CuriousTech/WiFi_Waterbed_Heater-2/README.md

# WiFi Waterbed Heater 2  
  
Discontinued, go here: [WiFiWaterbedHeater3](https://github.com/CuriousTech/WiFiWaterbedHeater3)
