CuriousTech/WiFi_Waterbed_Heater-2/3D/WBbtn.stl

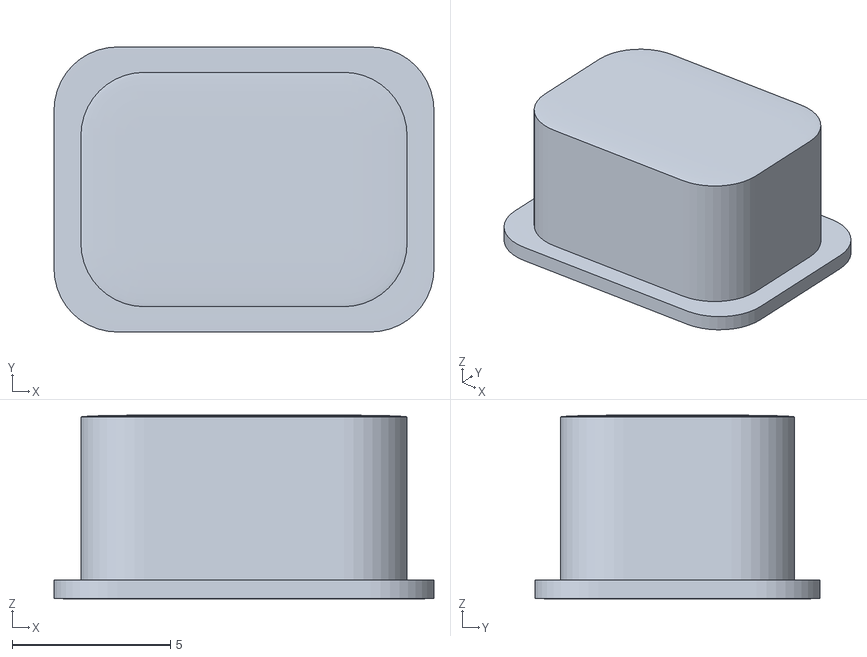
[picture p1: CAD file, 2020-01-23]
3D/WBbtn.stl
12.0 x 9.00 x 5.80
