CuriousTech/WiFi_Waterbed_Heater-2/3D/WBback.stl

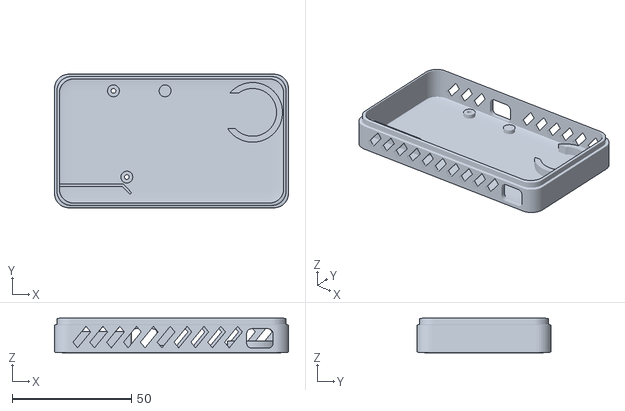
[picture p2: CAD file, 2020-01-23]
3D/WBback.stl
98.0 x 56.0 x 14.5
