CuriousTech/WiFi_Waterbed_Heater-2/Eagle/Supply/WaterbedSlave.brd

## EAGLE design Eagle/Supply/WaterbedSlave.brd (2020-01-21)

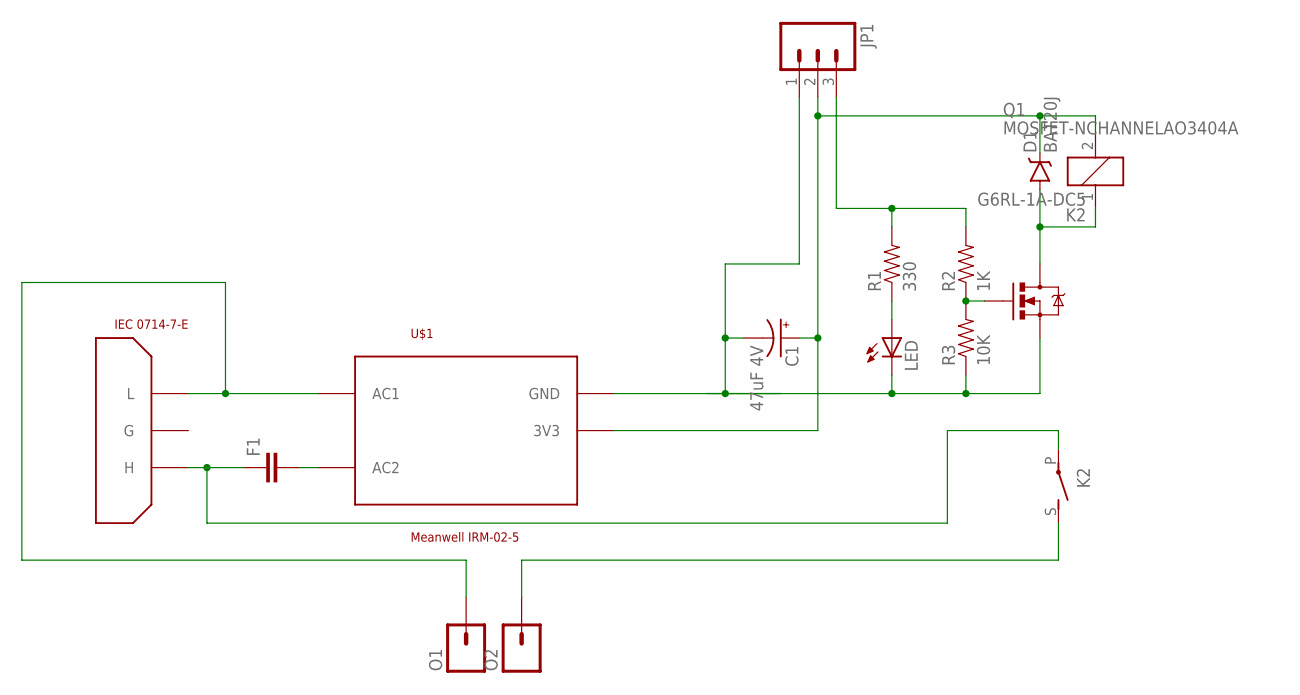
[picture p3: schematic WaterbedSlave.sch]

Parts:
C1: 47uF 4V; CPOL-RADIAL-10UF-25V
D1: BAT20J; SOD-323
F1: CAPPTH1; CAP-PTH-5MM
JP1: M03POLAR_LOCK; MOLEX-1X3_LOCK
K2: G6RL-1A-DC5; G6RS
LED: LEDCHIPLED_0805; CHIPLED_0805
O1, O2: M01PTH_2MM; 1X01_2MM
Q1: MOSFET-NCHANNELAO3404A; SOT23-3
R1: 330; 0805
R2: 1K; 0805
R3: 10K; 0805
U$1: Meanwell IRM-02-5; RAC02-3.3SC
U$3: IEC 0714-7-E; IEC

Connections:
3V3: C1.1 (+), D1.C, JP1.2, K2.2, U$1.GND (3V3)
GND: C1.2 (-), JP1.1, LED.C, Q1.2 (S), R3.1, U$1.3V3 (GND)
unnamed: O1.1, U$1.AC1, U$3.L
unnamed: F1.2, U$1.AC2
unnamed: K2.S, O2.1
unnamed: F1.1, K2.P, U$3.H
unnamed: D1.A, K2.1, Q1.3 (D)
unnamed: LED.A, R1.1
unnamed: JP1.3, R1.2, R2.2
unnamed: Q1.1 (G), R2.1, R3.2

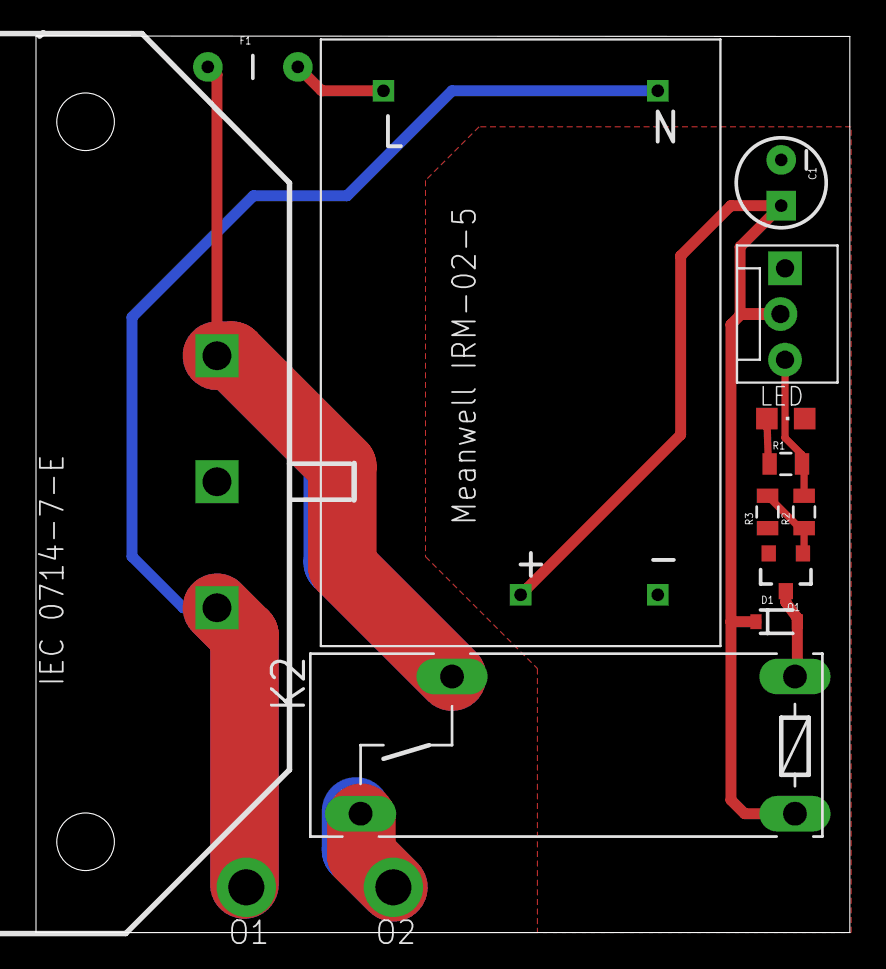
[picture p4: board WaterbedSlave.brd from above]

Board: 2 copper layers, 45.2 x 49.8 mm, 14 parts (0 on the bottom side), 10 nets.
