CuriousTech/WiFi_Waterbed_Heater-2/Eagle/WBH2.brd

## EAGLE design Eagle/WBH2.brd (2020-01-20)

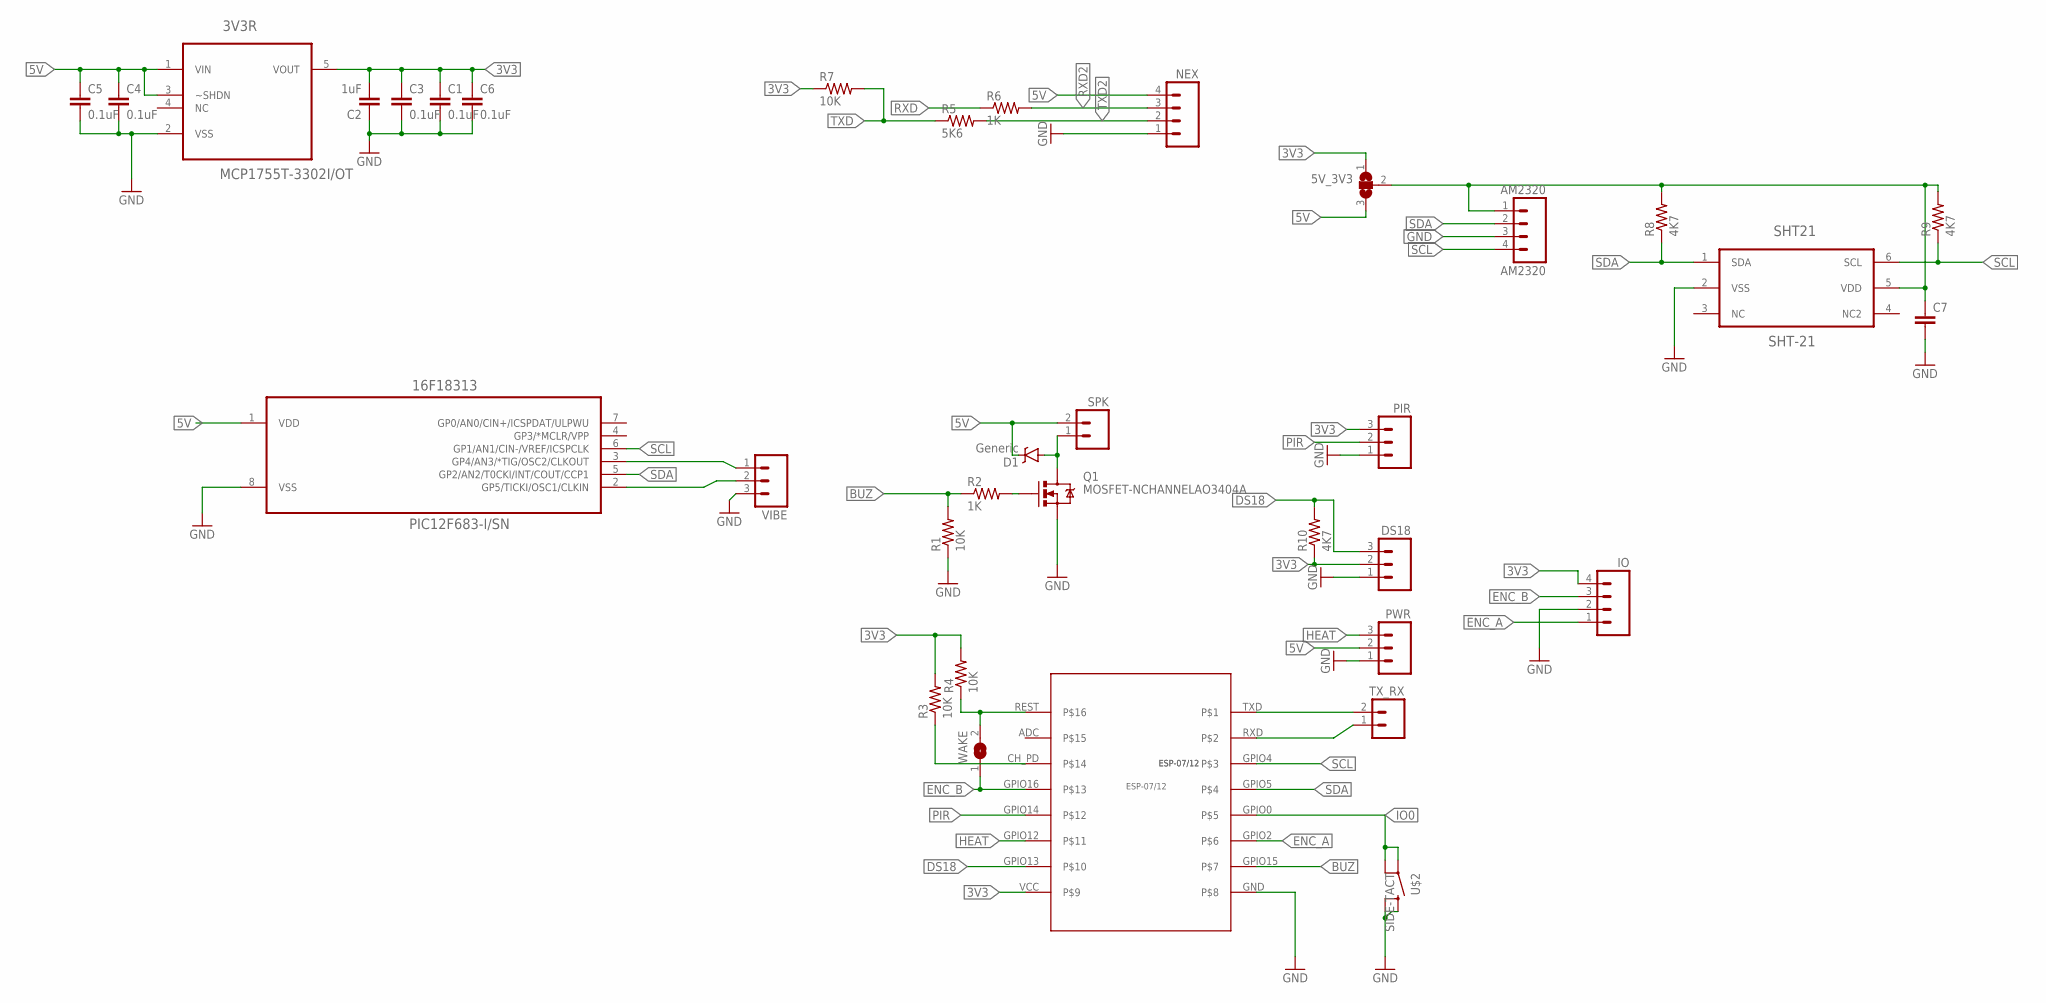
[picture p5: schematic WBH2.sch]

Parts:
3V3R: MCP1755T-3302I/OT; SOT95P270X145-5N
5V_3V3: SJ2W; SJ_2
16F18313: PIC12F683-I/SN; SOIC127P600X175-8N
AM2320: AM2320; 1X04
C1, C3, C4, C5, C6: 0.1uF; 0805
C2: 1uF; 0805
C7: CAP0603-CAP; 0603-CAP
D1: Generic; SOD-323
DS18: M03PTH; 1X03
IO: M04PTH; 1X04
NEX: M04PTH; 1X04
PIR: M03PTH; 1X03
PWR: M03PTH; 1X03
Q1: MOSFET-NCHANNELAO3404A; SOT23-3
R1, R3, R4, R7: 10K; 0805
R2, R6: 1K; 0805
R5: 5K6; 0805
R8, R9, R10: 4K7; 0805
SHT21: SHT-21; SHT21
SPK: M02PTH; 1X02
TX_RX: M02PTH; 1X02
U$1: ESP-07/12
U$2: SIDE-TACT
VIBE: M03PTH; 1X03
WAKE: SJ

Connections:
3V3: 3V3R.5 (VOUT), 5V_3V3.1, C1.1, C2.2, C3.1, C6.1, DS18.2, IO.4, PIR.3, R3.2, R4.2, R7.1, R10.1, U$1.VCC
5V: 3V3R.1 (VIN), 3V3R.3 (~SHDN), 5V_3V3.3, 16F18313.1 (VDD), C4.1, C5.1, D1.C, NEX.4, PWR.2, SPK.2
BUZ: R1.2, R2.1, U$1.GPIO15
DS18: DS18.3, R10.2, U$1.GPIO13
ENC_A: IO.1, U$1.GPIO2
ENC_B: IO.3, U$1.GPIO16, WAKE.1
GND: 3V3R.2 (VSS), 16F18313.8 (VSS), AM2320.3, C1.2, C2.1, C3.2, C4.2, C5.2, C6.2, C7.2, DS18.1, IO.2, NEX.1, PIR.1, PWR.1, Q1.2 (S), R1.1, SHT21.2 (VSS), U$1.GND, U$2.3 (2), U$2.4, VIBE.3
HEAT: PWR.3, U$1.GPIO12
IO0: U$1.GPIO0, U$2.1, U$2.2 (3)
unnamed: 16F18313.3 (GP4/AN3/*TIG/OSC2/CLKOUT), VIBE.1
unnamed: 16F18313.2 (GP5/TICKI/OSC1/CLKIN), VIBE.2
unnamed: D1.A, Q1.3 (D), SPK.1
unnamed: Q1.1 (G), R2.2
unnamed: R3.1, U$1.CH_PD
NC: SHT21.3 (NC)
PIR: PIR.2, U$1.GPIO14
PWR: 5V_3V3.2, AM2320.1, C7.1, R8.2, R9.2, SHT21.5 (VDD)
REST: R4.1, U$1.REST, WAKE.2
RXD: R6.1, TX_RX.1, U$1.RXD
RXD2: NEX.3, R6.2
SCL: 16F18313.6 (GP1/AN1/CIN-/VREF/ICSPCLK), AM2320.4, R9.1, SHT21.6 (SCL), U$1.GPIO4
SDA: 16F18313.5 (GP2/AN2/T0CKI/INT/COUT/CCP1), AM2320.2, R8.1, SHT21.1 (SDA), U$1.GPIO5
TXD: R5.1, R7.2, TX_RX.2, U$1.TXD
TXD2: NEX.2, R5.2

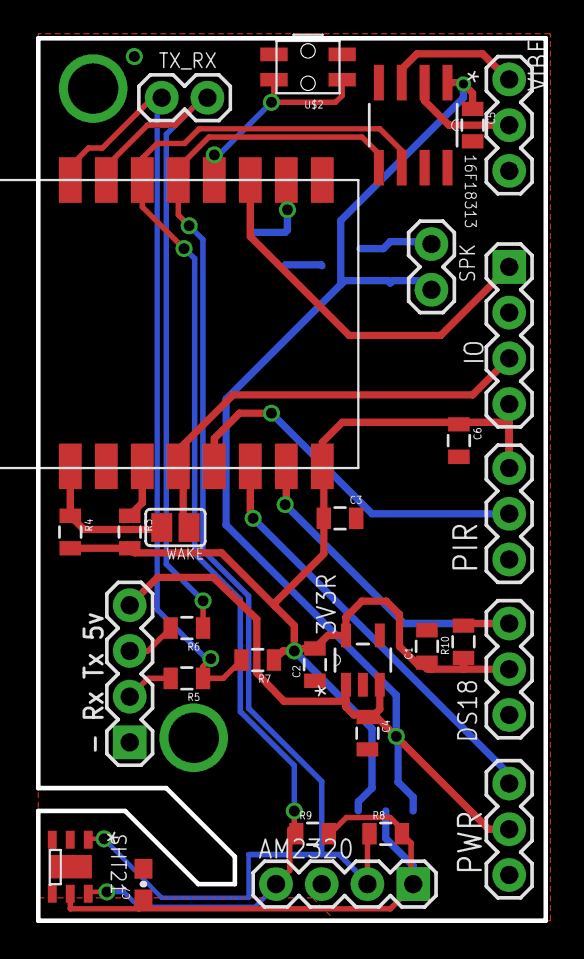
[picture p6: board WBH2.brd from above]

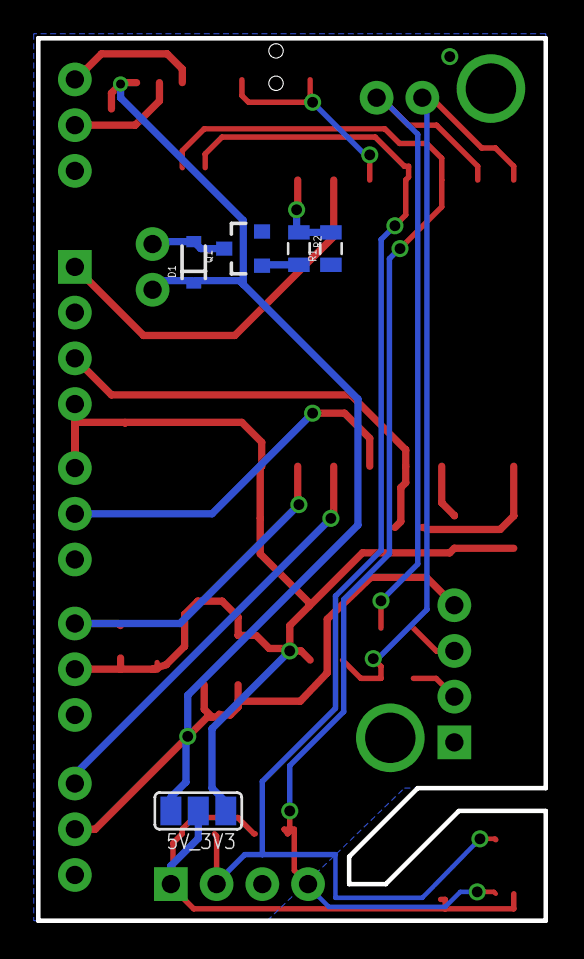
[picture p7: board WBH2.brd from below]

Board: 2 copper layers, 28.2 x 49.0 mm, 35 parts (5 on the bottom side), 23 nets.
