CuriousTech/WiFi_Waterbed_Heater-2/Arduino/display.cpp

#include "display.h"
#include "Nextion.h"
#include <ESPAsyncWebServer.h> // https://github.com/me-no-dev/ESPAsyncWebServer
#include <TimeLib.h>
#ifdef ESP32
#include <ESPmDNS.h>
#else
#include <ESP8266mDNS.h> // for WiFi.RSSI()
#endif
#include "eeMem.h"
#include "tempArray.h"
#include "music.h"

Nextion nex;
extern Music mus;
extern void changeTemp(int delta, bool bAll);
extern void CallHost(reportReason r);
extern bool bNotifAck;

extern TempArray ta;

void Display::init()
{
  nex.FFF(); // Just to end any debug strings in the Nextion
  nex.reset();
  screen( true ); // brighten the screen if it just reset
  nex.autoWake(true);
  refreshAll();
}

// called each second
void Display::oneSec()
{
  if(nex.getPage() == Page_Main)
  {
    refreshAll();    // time update every seconds
    updateRSSI();     //
    if( m_backlightTimer ) // the dimmer thing
    {
      if(--m_backlightTimer == 0)
        screen(false);
    }
  }
  else if(nex.getPage() == Page_Clock)
  {
    refreshClock();
  }
}

bool Display::checkNextion() // all the Nextion recieved commands
{
  static char cBuf[66];
  int len = nex.service(cBuf); // returns just the button value or 0 if no data
  uint8_t btn;
  uint32_t val;
  String s;
  static uint8_t textIdx = 0;
  bool bRtn = false;

  if(len == 0)
  {
    if(m_btnMode)
      if(--m_btnDelay <= 0)
      {
        buttonRepeat();
        m_btnDelay = 40; // repeat speed
      }
    return false;
  }

  switch(cBuf[0])  // code
  {
    case 0x65: // button
      bRtn = true; // anything pressed
      btn = cBuf[2];
      if( m_backlightTimer == 0)
      {
        nex.brightness(NEX_BRIGHT); // backlight was off, ignore this input
        m_backlightTimer = NEX_TIMEOUT;
        return bRtn;
      }
      if(cBuf[3]) // press, not release
        mus.add(6000, 20);

      switch(cBuf[1]) // page
      {
        case Page_Main:
          m_backlightTimer = NEX_TIMEOUT;
          switch(btn)
          {
            case 0: // screen (not used)
              break;
            case 1: // TIME
              break;
            case 4: // alarm
              m_bAlarmOn = !m_bAlarmOn;
              refreshAll();
              break;
            case 6: // temp up
              if(ee.bVaca) // first tap, disable vacation mode
                ee.bVaca = false;
              else
              {
                if(cBuf[3])
                {
                  m_btnMode = 1;
                  buttonRepeat();
                  m_btnDelay = 120;
                }
                else m_btnMode = 0;
              }
              break;
            case 7: // temp down
              if(ee.bVaca) // disable vacation mode
                ee.bVaca = false;
              else
              {
                if(cBuf[3])
                {
                  m_btnMode = 2;
                  buttonRepeat();
                  m_btnDelay = 120;
                }
                else m_btnMode = 0;
              }
              break;
            case 5: // dimmer slider
              if(cBuf[3]) // press
              {
                nex.getVal(0);
                m_bSliderDn = true;
              }
              else m_bSliderDn = false;
              break;
            case 14: // Light
              m_bLightOn = !m_bLightOn;
              m_LightSet = 1;
              break;
            case 17: // Alarm page
              nex.setPage(Page_Alarms); // set alarms
              updateAlarms();
              break;
            case 18: // Schedule page
              nex.setPage(Page_Schedule);
              updateSchedule();
              break;
            case 19: // Thermostat page
              break;
            case 26: // notifications ack
              m_bNotifVis = false;
              for(int i = 0; i < NOTIFS; i++)
              {
                if(m_Notif[i].s.length())
                {
                  nex.itemText(18, m_Notif[i].s);
                  m_sNotifCurr = m_Notif[i].s;
                  m_Notif[i].s = "";
                  m_bNotifVis = true;
                  break;
                }
              }
              if(m_bNotifVis == false)
                nex.visible("t18", 0);
//              if(m_notifIP[0])
  //            {
                bNotifAck = true;
                CallHost(Reason_Notif);
    //            m_notifIP[0] = 0;
      //        }
              break;
          }
          break;
        case Page_Thermostat:
          break;
        case Page_SSID: // Selection page t1=ID 2 ~ t16=ID 17
          WiFi.SSID(cBuf[2]-2).toCharArray(ee.szSSID, sizeof(ee.szSSID) );
          nex.refreshItem("t0"); // Just to terminate any debug strings in the Nextion
          nex.setPage(Page_Keyboard); // go to keyboard
          nex.itemText(1, "Enter Password");
          textIdx = 2; // AP password
          break;

        case Page_Alarms:
          switch(btn)
          {
            case 1: // up
              if(cBuf[3])
              {
                m_btnMode = 1;
                buttonRepeat();
                m_btnDelay = 120;
              }
              else m_btnMode = 0;
              break;
            case 2: // down
              if(cBuf[3])
              {
                m_btnMode = 2;
                buttonRepeat();
                m_btnDelay = 120;
              }
              else m_btnMode = 0;
              break;
            case 3 ... 17: // hour, minute, Am/Pm
              s = String("t") + m_almSelect; // change color back
              nex.itemColor(s, rgb16(0, 63, 31));
              m_almSelect = btn - 3;
              s = String("t") + m_almSelect; // change to new selection
              nex.itemColor(s, rgb16(31, 63, 31));
              updateAlarms();
              break;
            case 19 ... 53: // checkboxes
              {
                uint8_t alm = (btn-19)/7;
                uint8_t bit = (btn-19)%7;
                ee.alarm[alm].wday ^= 1 << bit;
              }
              break;
            case 18: // Main
              nex.setPage(Page_Main);
              delay(25);
              refreshAll();
              break;
          }
          break;
        case Page_Schedule:
          switch(btn)
          {
            case 1:
              nex.setPage(Page_Main);
              delay(25);
              refreshAll();
              break;
            case 3: // up
              schedUpDown(true);
              break;
            case 4: // down
              schedUpDown(false);
              break;
            case 5: case 6: case 7: case 8: case 9:
              selectSched(btn-5, 0); // name
              break;
            case 10: case 11: case 12: case 13: case 14:
              selectSched(btn-10, 1); // hour
              break;
            case 15: case 16: case 17: case 18: case 19:
              selectSched(btn-15, 2); // minute
              break;
            case 20: case 21: case 22: case 23: case 24:
              selectSched(btn-20, 3); // temp
              break;
            case 26: case 27: case 28: case 29: case 30:
              selectSched(btn-26, 4); // thresh
              break;
            case 25: // All
              selectSched(0, 5);
              break;
          }
          break;
        case Page_Clock:
          screen(true);
          break;
        default:
          break;
      }
      break;
    case 0x70:// string return from keyboard
      switch(textIdx)
      {
        case 0: // zipcode edit
//          if(strlen(cBuf + 1) < 5)
//            break;
//          strncpy(ee.zipCode, cBuf + 1, sizeof(ee.zipCode));
          break;
        case 1: // password edit
//          if(strlen(cBuf + 1) < 5)
//            return;
//          strncpy(ee.password, cBuf + 1, sizeof(ee.password) );
          break;
        case 2: // AP password
          nex.setPage(Page_Main);
          strcpy(ee.szSSIDPassword, cBuf + 1);
          break;
      }
      screen(true); // back to main page
      break;
    case 0x71: // numeric data
      val = cBuf[1] | (cBuf[2] << 8) | (cBuf[3] << 16) | (cBuf[4] << 24);
      switch(nex.m_valItem)
      {
        case 0: // light level
          bool bSend = (m_nLightLevel != val) ? true:false;
          m_nLightLevel = val;
          if(bSend)
            m_LightSet = 2;
          if(m_bSliderDn)
            nex.getVal(nex.m_valItem);
          break;
      }
      break;
  }
  return bRtn;
}

void Display::selectSched(uint8_t row, uint8_t col)
{
  String s;
  if(m_schedCol < 5)
  {
    s = String("t") + ((m_schedCol *5) + m_schedRow); // change color back
    nex.itemColor(s, rgb16(0, 63, 31));
  }
  m_schedRow = row;
  m_schedCol = col;
  if(m_schedCol < 5)
  {
    s = String("t") + ((m_schedCol * 5) + m_schedRow); // change selected to white
    nex.itemColor(s, rgb16(31, 63, 31));
  }
}

void Display::schedUpDown(bool bUp)
{
  String s;
  uint8_t m;

  switch(m_schedCol)
  {
    case 0: // name
      break;
    case 1: // hour
      ee.schedule[m_season][m_schedRow].timeSch += (bUp ? 60:-60);
      ee.schedule[m_season][m_schedRow].timeSch %= 1440;
      s = String(ee.schedule[m_season][m_schedRow].timeSch / 60) + ":";
      nex.itemText(m_schedRow + 5, s );
      break;
    case 2: // minute
      ee.schedule[m_season][m_schedRow].timeSch += (bUp ? 1:-1);
      ee.schedule[m_season][m_schedRow].timeSch %= 1440;
      m = ee.schedule[m_season][m_schedRow].timeSch % 60;
      s = "";
      if(m < 10) s = "0";
      s += m;
      nex.itemText(m_schedRow + 10, s );
      break;
    case 3: // temp
      nex.refreshItem("s0");
      delay(10); // was 6
      ee.schedule[m_season][m_schedRow].setTemp += (bUp ? 1:-1);
      ee.schedule[m_season][m_schedRow].setTemp = constrain(ee.schedule[m_season][m_schedRow].setTemp, 600, 900);
      nex.itemText(m_schedRow + 15, String((float)ee.schedule[m_season][m_schedRow].setTemp/10, 1) );
      ta.draw();
      break;
    case 4: // thresh
//      nex.refreshItem("s0");
      ee.schedule[m_season][m_schedRow].thresh += (bUp ? 1:-1);
      ee.schedule[m_season][m_schedRow].thresh %= 10;
      nex.itemText(m_schedRow + 20, String(ee.schedule[m_season][m_schedRow].thresh) );
//      ta.draw();
      break;
    case 5: // all
      nex.refreshItem("s0");
      delay(10); // was 4
      for(uint8_t i = 0; i < 5; i++)
      {
        ee.schedule[m_season][i].setTemp += (bUp ? 1:-1);
        ee.schedule[m_season][i].setTemp = constrain(ee.schedule[m_season][i].setTemp, 600, 900);
        nex.itemText(i + 15, String((float)ee.schedule[m_season][i].setTemp/10, 1) );
      }
      ta.draw();
      break;
  }
}

void Display::Notification(String s, IPAddress ip)
{
  display.screen(true);
  if(m_bNotifVis) // stuff it
  {
    bool bAdd = true;
    for(int i = 0; i < NOTIFS; i++)
    {
      if(m_Notif[i].s.equals(s))
      {
        bAdd = false;
        break;
      }
    }
    if(bAdd) for(int i = 0; i < NOTIFS; i++)
    {
      if(m_Notif[i].s.length() == 0)
      {
        m_Notif[i].s = s;
        m_Notif[i].ip = ip;
        break;
      }
    }
  }
  else // first
  {
    nex.visible("t18", 1);
    nex.itemText(18, s);
    m_sNotifCurr = s;
    m_bNotifVis = true;
    m_notifIP = ip; // just works if nothing else is displayed
  }
  mus.add(3000, 100); // notification sound
}

void Display::NotificationCancel(String s)
{
  for(int i = 0; i < NOTIFS; i++)
  {
    if(m_Notif[i].s.equals(s))
      m_Notif[i].s = "";
  }

  if(m_bNotifVis == m_sNotifCurr.equals(s))
  {
    m_bNotifVis = false;
    m_sNotifCurr = "";
    nex.visible("t18", 0);
  }
}

void Display::buttonRepeat()
{
  uint8_t alm;
  uint8_t sel;
  uint8_t m;
  String s;

  switch(nex.getPage())
  {
    case Page_Main:
      changeTemp((m_btnMode==1) ? 1:-1, true);
      refreshAll();
      break;
    case Page_Alarms:
      alm = m_almSelect % 5;
      sel = m_almSelect / 5;
      if(m_btnMode == 1) // up
      {
        switch(sel)
        {
          case 0: // hour
            ee.alarm[alm].timeSch += 60;
            ee.alarm[alm].timeSch %= 24*60;
            break;
          case 1:
            if(++ee.alarm[alm].timeSch >= 24*60)
              ee.alarm[alm].timeSch = 0;
            break;
          case 2: // AM/PM
            ee.alarm[alm].timeSch += 12*60;
            ee.alarm[alm].timeSch %= 24*60;
            break;
        }
      }
      else switch(sel)
      {
          case 0: // hour
            ee.alarm[alm].timeSch -= 60;
            ee.alarm[alm].timeSch %= 24*60;
            break;
          case 1:
            if(--ee.alarm[alm].timeSch < 0)
              ee.alarm[alm].timeSch = 24*60 - 1;
            break;
          case 2: // AM/PM
            ee.alarm[alm].timeSch -= 12*60;
            ee.alarm[alm].timeSch %= 24*60;
            break;
      }
      switch(sel)
      {
        case 0: // hour
          m = ee.alarm[alm].timeSch / 60;
          if(m  == 0) m = 12;
          s = m;
          s += ":";
          nex.itemText(m_almSelect, s);
          break;
        case 1: // minute
          s = "";
          m = ee.alarm[alm].timeSch % 60;
          if(m < 10) s = "0";
          s += m;
          nex.itemText(m_almSelect, s);
          break;
        case 2: // AM/PM
          nex.itemText(m_almSelect, (ee.alarm[alm].timeSch) > (11*60) ? "PM":"AM");
          break;
      }
      break;
    case Page_Schedule:
      break;
  }
  mus.add(6000, 20);
}

String Display::fmtTime(uint16_t v)
{
  String s;
  uint8_t h = v / 60;
  bool bPM = (h > 11) ? true:false;
  if (h > 12)
    h -= 12;
  if(h == 0)
    h = 12;
  if(h < 10) s += " ";
  s += h;
  s += ":";
  uint8_t m = v % 60;
  if(m < 10) s += "0";
  s += m;
  s += bPM ? " PM":" AM";
  return s;
}

void Display::nextAlarm() // find next active alarm
{
  uint8_t tm = hour() * 60 + minute();

  m_alarmIdx = 0;
  for(int i = MAX_SCHED - 1; i >= 0; i--)
  {
    if(tm < ee.alarm[i].timeSch)
      break;
    if(ee.alarm[i].wday & (1 << weekday()) )
      m_alarmIdx = i;
  }
}

const char *_days_short[] = {"Sun", "Mon", "Tue", "Wed", "Thu", "Fri", "Sat"};
const char *_mon[] = {"","JAN", "FEB", "MAR", "APR", "MAY", "JUN", "JUL", "AUG", "SEP", "OCT", "NOV", "DEC"};

void Display::refreshAll()
{
  static int save[12];

  if(nex.getPage())// || m_bNotifVis) // not on main page or notification on
  {
    save[0] = -1;
    save[5] = -1;
    save[7] = -1;
    return;  // t7 and t8 are only on thermostat (for now)
  }

  String sTime;

  if(minute() != save[0])
  {
    save[0] = minute();
    sTime = String( hourFormat12() );
    sTime += ":";
    if(minute() < 10) sTime += "0";
    sTime += minute();
    nex.itemText(0, sTime);
    sTime = _mon[month()];
    sTime += " ";
    sTime += day();
    nex.itemText(2, sTime);
    nex.itemText(13, isPM() ? "PM":"AM");
    nextAlarm();
  }
  sTime = "";
  if(second() < 10) sTime += "0";
  sTime += second();
  nex.itemText(1, sTime);

  if(save[1] != m_currentTemp)
  {
    save[1] = m_currentTemp;
    nex.itemText(5, String((float)m_currentTemp/10, 1) );
  }
  if(save[2] != m_hiTemp)
  {
    save[2] = m_hiTemp;
    nex.itemText(4, String((float)m_hiTemp/10, 1) );
  }
  if(save[3] != m_roomTemp)
  {
    save[3] = m_roomTemp;
    nex.itemText(15, String((float)m_roomTemp/10, 1) + " " );
  }
  if(save[4] != m_rh)
  {
    save[4] = m_rh;
    nex.itemText(16, String((float)m_rh/10, 1) + "%" );
  }
  if((bool)save[5] != m_bAlarmOn || m_alarmIdx != save[6])
  {
    save[5] = m_bAlarmOn;
    save[6] = m_alarmIdx;
    sTime = "ALARM ";
    sTime += fmtTime(ee.alarm[m_alarmIdx].timeSch);
    sTime += m_bAlarmOn ? " ON " : " OFF";
    nex.itemText(3, sTime );
    nex.itemColor("t3", m_bAlarmOn ? rgb16(31,0,0):rgb16(15,0,31) );
  }
  if(save[7] != m_bHeater)
  {
    save[7] = m_bHeater;
    nex.itemColor("t5", m_bHeater ? rgb16(31,0,0):rgb16(15,0,31) );
  }
  if(save[8] != m_schInd)
  {
    save[8] = m_schInd;
    if(ee.bVaca)
      sTime = "Vacation";
    else
    {
      sTime = _days_short[weekday()-1];
      sTime += "  ";
      sTime += String(m_schInd);
    }
    nex.itemText(12, sTime );
  }
  if(save[9] != m_outTemp)
  {
    save[9] = m_outTemp;
    nex.itemText(8, String((float)m_outTemp/10, 1) + " " );
  }
  if(save[10] != m_outRh)
  {
    save[10] = m_outRh;
    nex.itemText(9, String((float)m_outRh/10, 1) + "%" );
  }
}

void Display::refreshClock()
{
  
}

bool Display::checkAlarms()
{
  if(m_bAlarmOn == false)
    return false;
  uint16_t tm = (hour() * 60) + minute();
  for(int i = 0; i < 5; i++)
  {
    if(ee.alarm[i].wday && ee.alarm[i].timeSch == tm)
    {
      if(ee.alarm[i].wday & 1<<day()) // check day bit
        return true;
    }
  }
  return false;
}

void Display::updateAlarms()
{
  String s;
  for(int i = 0; i < 5; i++)
  {
    uint16_t v = ee.alarm[i].timeSch;
    uint8_t h = v / 60;
    nex.itemText(i+10, (h > 11) ? "PM":"AM");
    if(h == 0) h =12;
    else if(h > 12) h -= 12;
    s = h;
    s += ":";
    nex.itemText(i, s);
    uint8_t m = v % 60;
    s = "";
    if(m < 10) s = "0";
    s += m;
    nex.itemText(i+5, s);
    for(int cb = 0; cb < 7; cb++)
    {
      nex.checkItem(i * 7 + cb, ee.alarm[i].wday & (1 << cb) ? 1:0);
      delay(5); // fix the buffer oveflow
    }
  }
}

void Display::updateSchedule()
{
  for(uint8_t i = 0; i < ee.schedCnt[m_season] && i < 5; i++)
  {
//    nex.itemText(i, ee.schedule[m_season][i].name );
    nex.itemText(i+5, String(ee.schedule[m_season][i].timeSch / 60) + ":" );
    uint8_t sec = ee.schedule[m_season][i].timeSch % 60;
    String s = "";
    if(sec < 10) s = "0";
    s += sec;
    nex.itemText(i+10, s );
    nex.itemText(i+15, String((float)ee.schedule[m_season][i].setTemp/10, 1) );
    nex.itemText(i+20, String(ee.schedule[m_season][i].thresh ) );
    if(m_schInd == i)
    {
      nex.backColor(String("t")+i, rgb16(12,20,8));
    }
    delay(5);
  }
  ta.draw();
}

// Set slider to dimmer level
void Display::updateLevel(uint8_t lvl)
{
  m_nLightLevel = lvl;
  nex.setVal(0, lvl);
}

// true: set screen backlight to bright plus switch to main
// false: switch to blank and dim
bool Display::screen(bool bOn)
{
  if(WiFi.status() != WL_CONNECTED )
    return false;
  static bool bOldOn = true;

  if(bOldOn && nex.getPage()) // not in sync
    bOldOn = false;

  if(bOn) // input or other reason
  {
    nex.brightness(NEX_BRIGHT);
    m_backlightTimer = NEX_TIMEOUT; // update the auto backlight timer
    if( bOn == bOldOn )
      return false; // no change occurred
    if(nex.getPage())
    {
      nex.setPage(Page_Main);
      delay(25);
    }
    if(m_bNotifVis)
      mus.add(3000, 100); // notification sound
    refreshAll();
  }
  else
  {
      nex.brightness(NEX_OFF);
      if(nex.getPage())
        nex.setPage(Page_Main); // always wake on home page
  }
  bOldOn = bOn;
  return true; // it was changed
}

// return true if backlight is off
bool Display::isOff()
{
  return (m_backlightTimer == 0) ? true:false;
}

void Display::updateRSSI()
{
  static uint8_t seccnt = 2;
  static int16_t rssiT;
#define RSSI_CNT 8
  static int16_t rssi[RSSI_CNT];
  static uint8_t rssiIdx = 0;

  if(nex.getPage()) // must be page 0
  {
    rssiT = 0; // cause a refresh later
    seccnt = 1;
    return;
  }
  if(--seccnt)
    return;
  seccnt = 3;     // every 3 seconds

  rssi[rssiIdx] = WiFi.RSSI();
  if(++rssiIdx >= RSSI_CNT) rssiIdx = 0;

  int16_t rssiAvg = 0;
  for(int i = 0; i < RSSI_CNT; i++)
    rssiAvg += rssi[i];

  rssiAvg /= RSSI_CNT;
  if(rssiAvg == rssiT)
    return;

  nex.itemText(7, String(rssiT = rssiAvg) + "dB");

  int sigStrength = 127 + rssiT;
  int wh = 24; // width and height
  int x = 12; // X/Y position
  int y = 180;
  int sect = 127 / 5; // 25
  int dist = wh  / 5; // distance between blocks

  y += wh;
  static uint8_t oldBars;
  uint8_t bars = sigStrength / sect;

  if(bars == oldBars)
    return;
  oldBars = bars;
  for (int i = 1; i < 6; i++)
  {
    nex.fill( x + i*dist, y - i*dist, dist-2, i*dist, (sigStrength > i * sect) ? rgb16(0, 63,31) : rgb16(5, 10, 5) );
  }
}
