CuriousTech/WiFi_Waterbed_Heater-2/(commit log)

2021-01-25 fix divide by 0
    [Waterbed2.ino]
2024-06-10 Added ESP32 support and LD2410 (req ESP32)
2024-06-10 Uses Preferences for ESP32
2024-06-10 Added ESP32 support, LD2410 (req ESP32), 4 season temp set
